mar87649/Autonomus-Rescue-Rover/Photos/20181127_203600.jpg

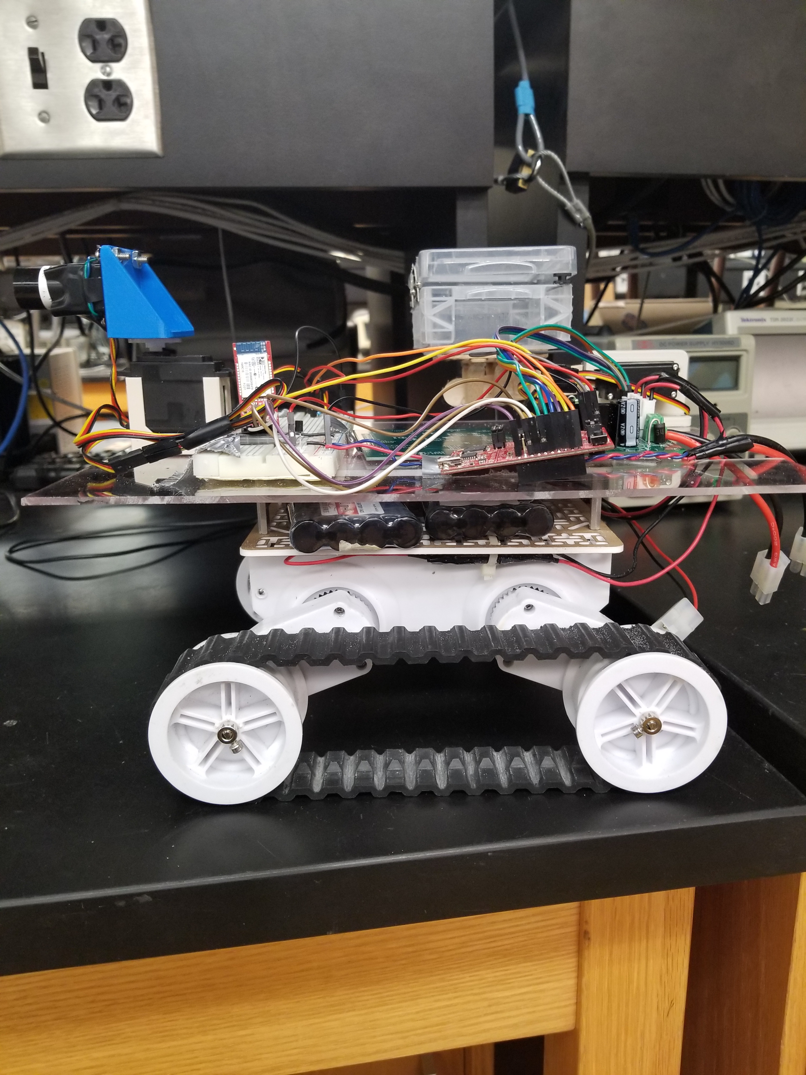
Photos/20181127_203600.jpg
