mar87649/Autonomus-Rescue-Rover/README.md

# Autonomous-Room-Mapping-Robot

# Description: 
Room mapping robot that can detect and avoid obstacles. 
Room is displayed in 2D via GUI.

# Status: 
Development has stopped
