mar87649/Autonomus-Rescue-Rover/PCB/board.PNG

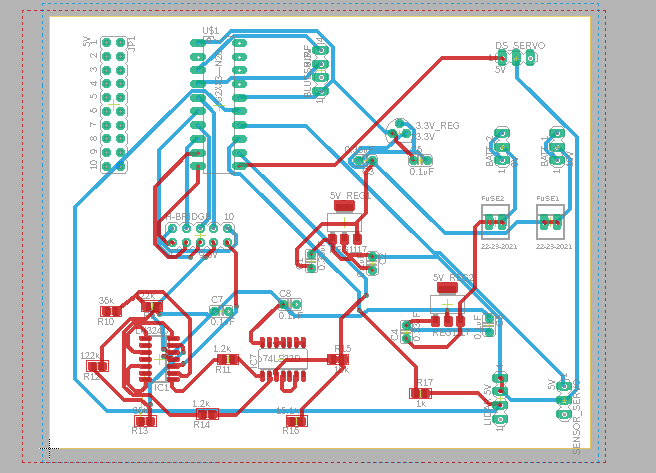
PCB/board.PNG
