mar87649/Autonomus-Rescue-Rover/Photos/20181113_170000.jpg

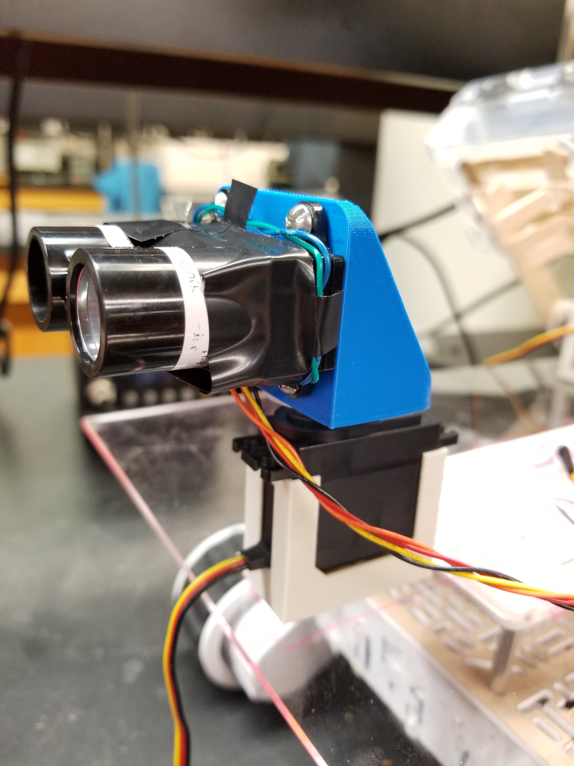
Photos/20181113_170000.jpg
