mar87649/Autonomus-Rescue-Rover/Photos/20181113_170115.jpg

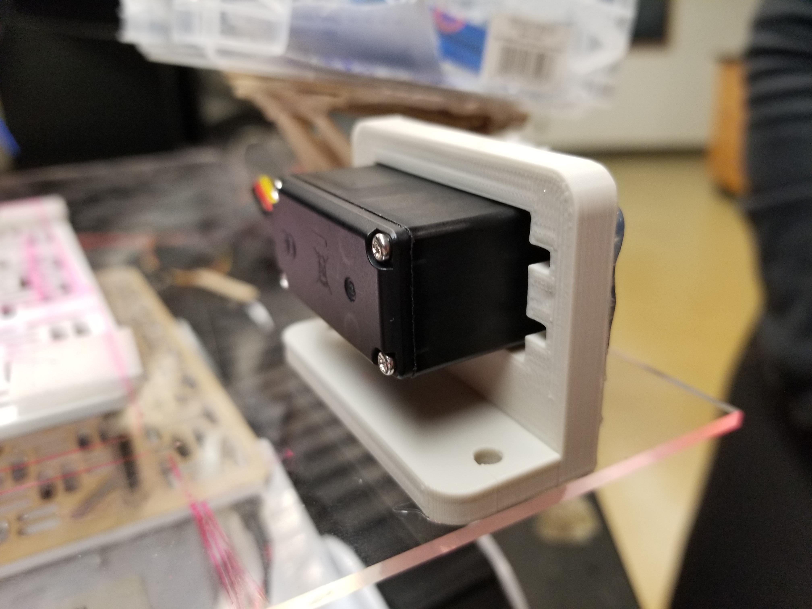
Photos/20181113_170115.jpg
