mar87649/Autonomus-Rescue-Rover/Photos/20181113_170211.jpg

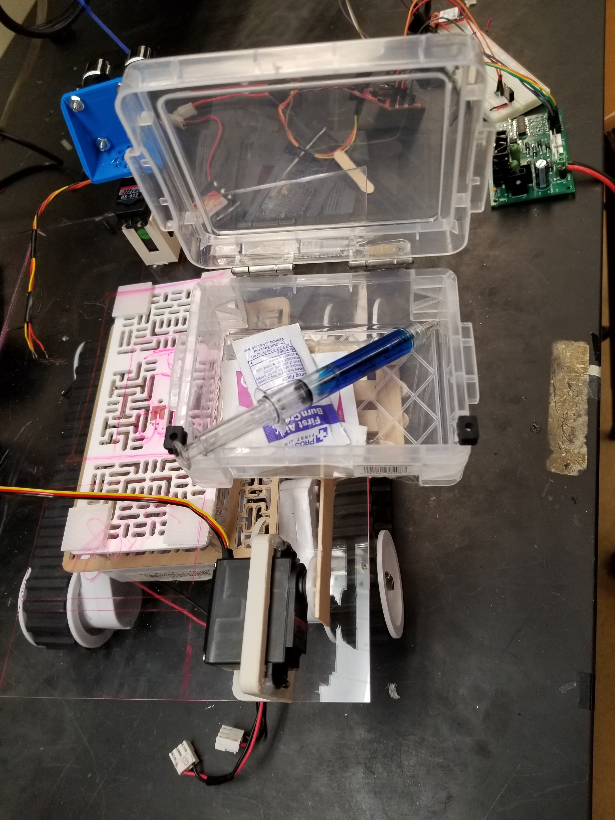
Photos/20181113_170211.jpg
