mar87649/Autonomus-Rescue-Rover/Photos/20181113_170213.jpg

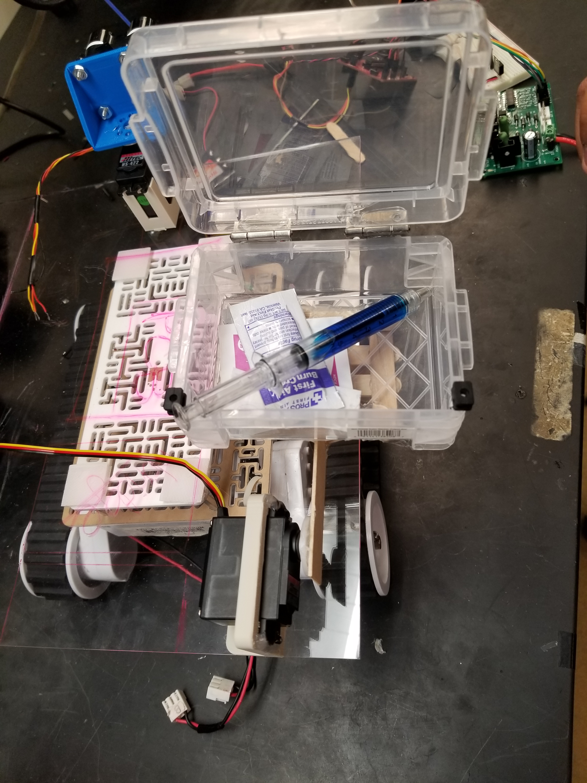
Photos/20181113_170213.jpg
