mar87649/Autonomus-Rescue-Rover/Photos/20181113_170230.jpg

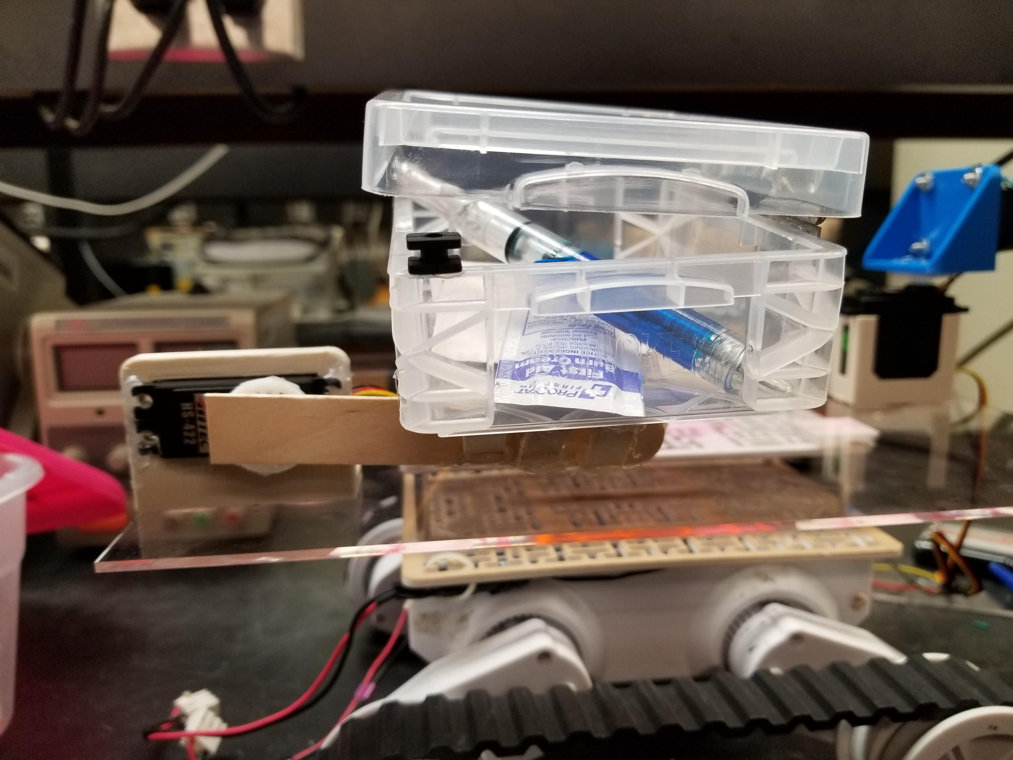
Photos/20181113_170230.jpg
