mar87649/Autonomus-Rescue-Rover/Photos/20181113_170255.jpg

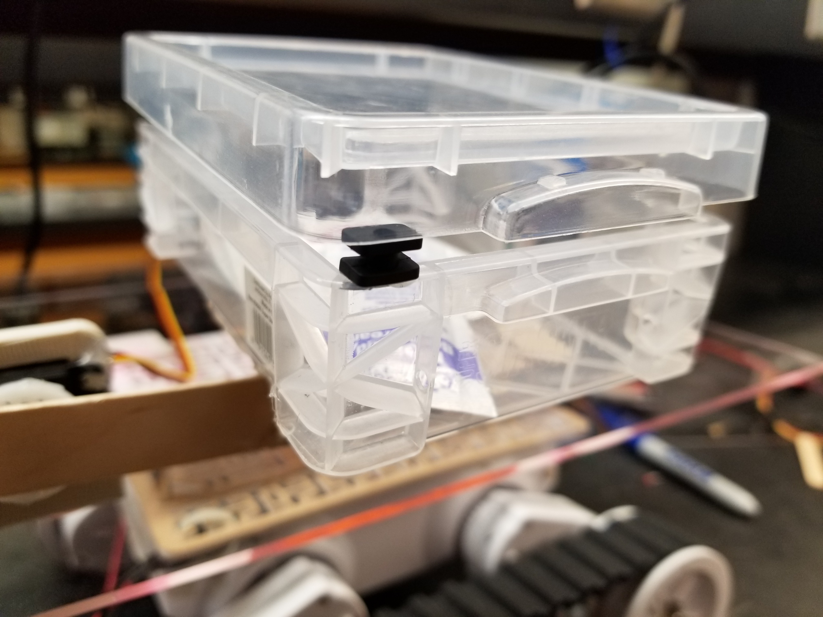
Photos/20181113_170255.jpg
