mar87649/Autonomus-Rescue-Rover/Photos/20181113_205037.jpg

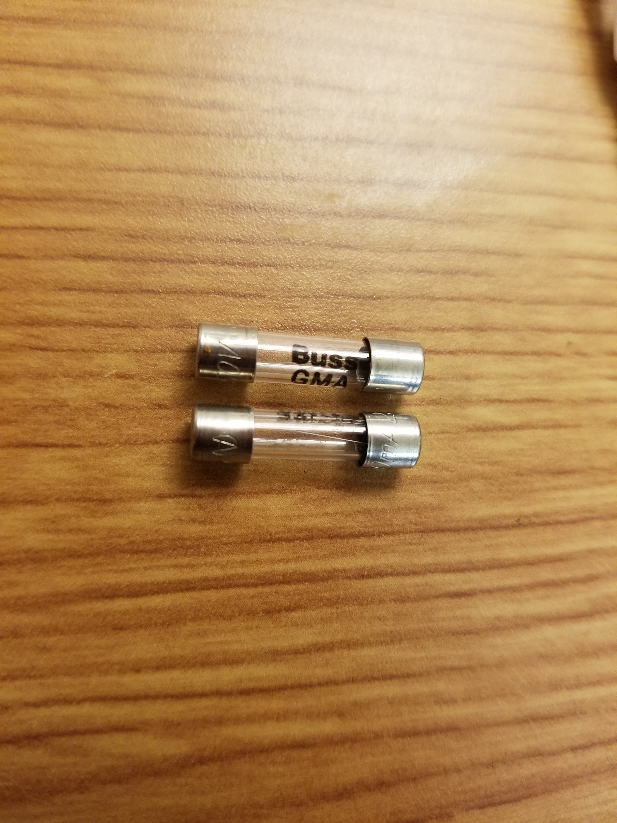
Photos/20181113_205037.jpg
