mar87649/Autonomus-Rescue-Rover/Photos/20181127_200213.jpg

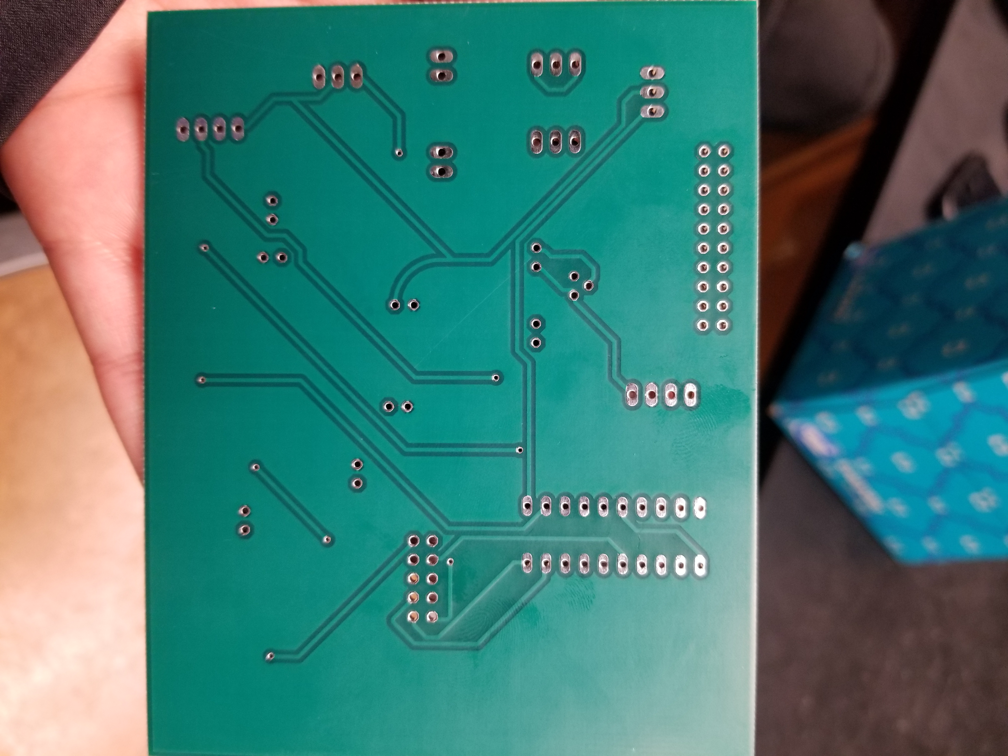
Photos/20181127_200213.jpg
