mar87649/Autonomus-Rescue-Rover/Photos/20181127_203509.jpg

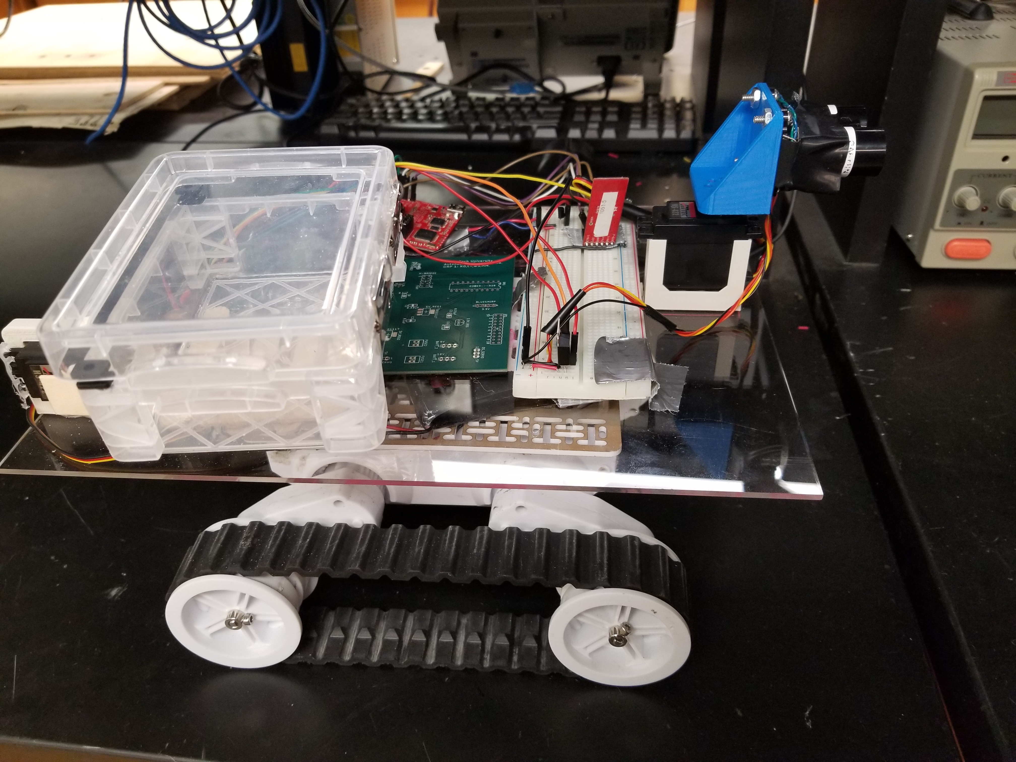
Photos/20181127_203509.jpg
