mar87649/Autonomus-Rescue-Rover/Photos/Snapchat-1557375275.jpg

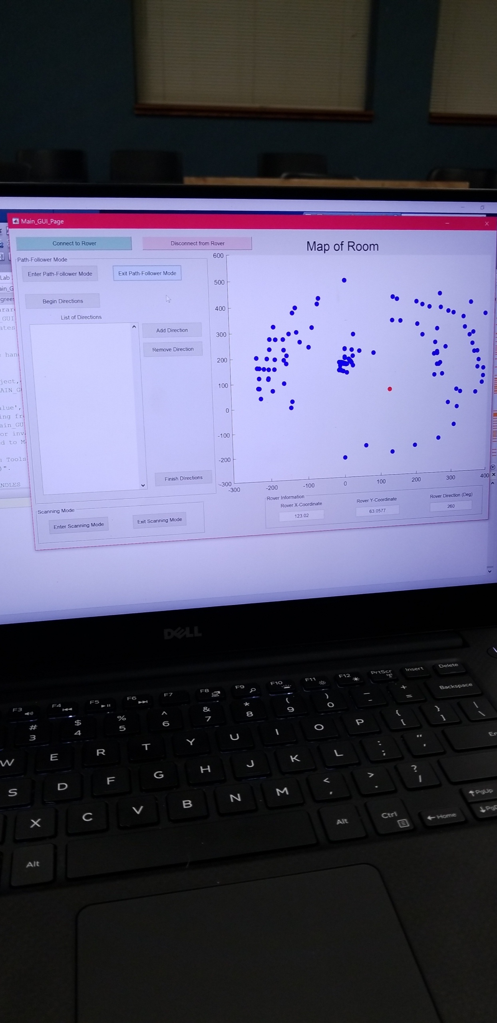
Photos/Snapchat-1557375275.jpg
