mar87649/Autonomus-Rescue-Rover/PCB/Lab 3 PCB_schematic_redo.brd

## EAGLE design PCB/Lab 3 PCB_schematic_redo.brd (2019-08-03)

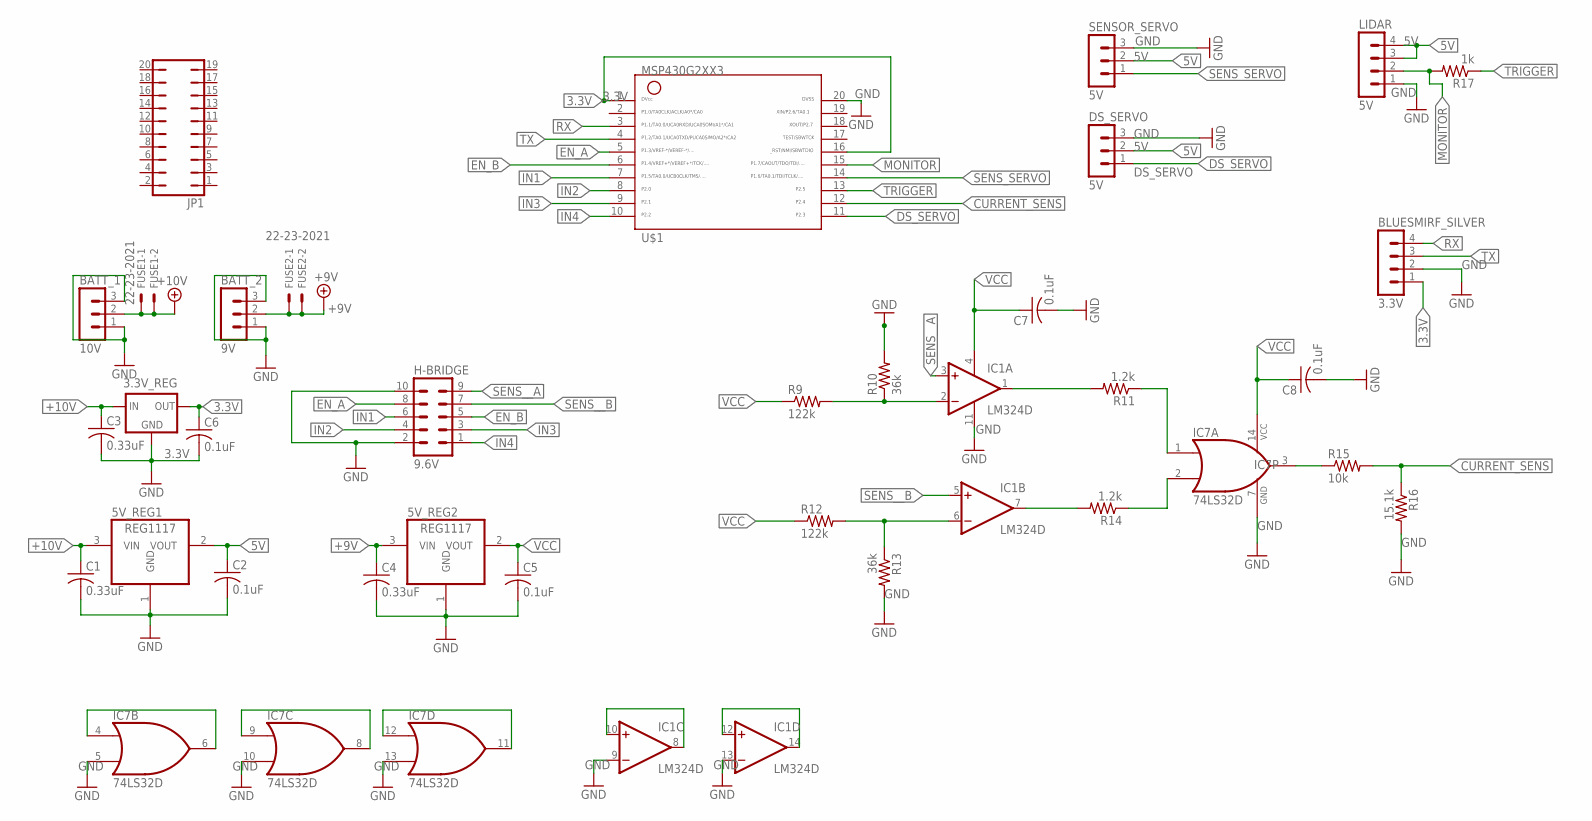
[picture p34: schematic Lab 3 PCB_schematic_redo.sch]

Parts:
3.3V_REG: 3.3V; 78LXX
5V_REG1, 5V_REG2: REG1117; SOT223
BATT_1: 10V; MA03-1
BATT_2: 9V; MA03-1
BLUESMIRF_SILVER: 3.3V; MA04-1
C1, C3, C4: 0.33uF; C025-024X044
C2, C5, C6, C7, C8: 0.1uF; C025-024X044
DS_SERVO: 5V; MA03-1
FUSE1, FUSE2: 22-23-2021
H-BRIDGE: 9.6V; MA05-2
IC1: LM324D; SO14
IC7: 74LS32D; SO14
JP1: JP10Q
LIDAR: 5V; MA04-1
R9, R12: 122k; R0805
R10, R13: 36k; R0805
R11, R14: 1.2k; R0805
R15: 10k; R0805
R16: 15.1k; R0805
R17: 1k; R0805
SENSOR_SERVO: 5V; MA03-1
U$1: G2XX3---N20; N20

Connections:
3.3V: 3.3V_REG.OUT, BLUESMIRF_SILVER.1, C6.1, U$1.1, U$1.16
5V: 5V_REG1.2 (VOUT), C2.1, DS_SERVO.2, LIDAR.3, LIDAR.4, SENSOR_SERVO.2
+9V: 5V_REG2.3 (VIN), BATT_2.2, C4.1, FUSE2.1, FUSE2.2
+10V: 3.3V_REG.IN, 5V_REG1.3 (VIN), BATT_1.2, C1.1, C3.1, FUSE1.1, FUSE1.2
CURRENT_SENS: R15.2, R16.1, U$1.12
DS_SERVO: DS_SERVO.1, U$1.11
EN_A: H-BRIDGE.8, U$1.5
EN_B: H-BRIDGE.5, U$1.6
GND: 3.3V_REG.GND, 5V_REG1.1 (GND), 5V_REG2.1 (GND), BATT_1.1, BATT_1.3, BATT_2.1, BATT_2.3, BLUESMIRF_SILVER.2, C1.2, C2.2, C3.2, C4.2, C5.2, C6.2, C7.2, C8.2, DS_SERVO.3, H-BRIDGE.2, H-BRIDGE.10, IC1.9 (-IN), IC1.11 (V-), IC1.13 (-IN), IC7.5 (I1), IC7.7 (GND), IC7.10 (I1), IC7.13 (I1), LIDAR.1, R10.2, R13.2, R16.2, SENSOR_SERVO.3, U$1.20
IN1: H-BRIDGE.6, U$1.7
IN2: H-BRIDGE.4, U$1.8
IN3: H-BRIDGE.3, U$1.9
IN4: H-BRIDGE.1, U$1.10
MONITOR: LIDAR.2, R17.2, U$1.15
unnamed: IC7.4 (I0), IC7.6 (O)
unnamed: IC1.6 (-IN), R12.2, R13.1
unnamed: IC1.2 (-IN), R9.2, R10.1
unnamed: IC7.1 (I0), R11.1
unnamed: IC1.8 (OUT), IC1.10 (+IN)
unnamed: IC1.1 (OUT), R11.2
unnamed: IC1.7 (OUT), R14.2
unnamed: IC7.2 (I1), R14.1
unnamed: IC7.3 (O), R15.1
unnamed: IC7.8 (O), IC7.9 (I0)
unnamed: IC7.11 (O), IC7.12 (I0)
unnamed: IC1.12 (+IN), IC1.14 (OUT)
RX: BLUESMIRF_SILVER.4, U$1.3
SENS_SERVO: SENSOR_SERVO.1, U$1.14
SENS__A: H-BRIDGE.9, IC1.3 (+IN)
SENS__B: H-BRIDGE.7, IC1.5 (+IN)
TRIGGER: R17.1, U$1.13
TX: BLUESMIRF_SILVER.3, U$1.4
VCC: 5V_REG2.2 (VOUT), C5.1, C7.1, C8.1, IC1.4 (V+), IC7.14 (VCC), R9.1, R12.1

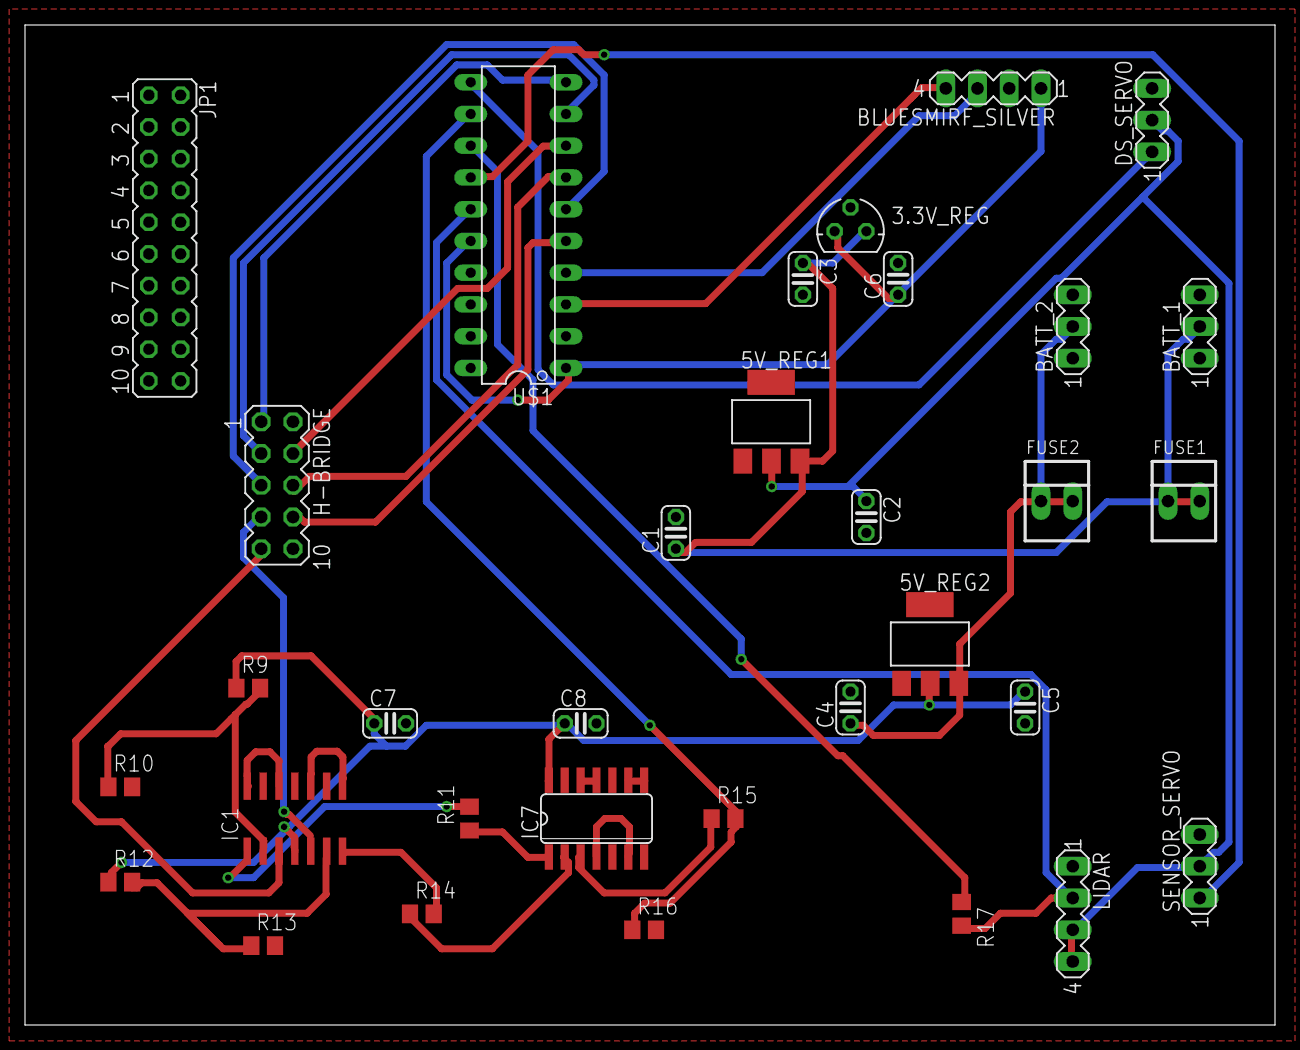
[picture p35: board Lab 3 PCB_schematic_redo.brd from above]

Board: 2 copper layers, 100.0 x 80.0 mm, 33 parts (0 on the bottom side), 33 nets.
