mar87649/Autonomus-Rescue-Rover/Library Motor Control/Include/MotorControl.h

/*
 * MotorControl.h
 *
 *  Created on: Sep 30, 2018
 *      Author: Gaming-Jim
 */

#ifndef DEBUG_INCLUDE_MOTORCONTROL_H_
#define DEBUG_INCLUDE_MOTORCONTROL_H_

int add(int a, int b);

void motor_A_clockwise();

void motor_A_counterclockwise();

void motor_B_clockwise();

void motor_B_counterclockwise();

void move_forward();

void move_reverse();

void turn_left();

void turn_right();

void stop();

#endif /* DEBUG_INCLUDE_MOTORCONTROL_H_ */
