mar87649/Autonomus-Rescue-Rover/graph.py

# -*- coding: utf-8 -*-

# Form implementation generated from reading ui file 'graph.ui'
#
# Created by: PyQt5 UI code generator 5.11.3
#
# WARNING! All changes made in this file will be lost!

from PyQt5 import QtCore, QtGui, QtWidgets

class Ui_MainWindow(object):
    def setupUi(self, MainWindow):
        MainWindow.setObjectName("MainWindow")
        self.centralwidget = QtWidgets.QWidget(MainWindow)
        self.centralwidget.setObjectName("centralwidget")
        self.pushButton = QtWidgets.QPushButton(self.centralwidget)
        self.pushButton.setGeometry(QtCore.QRect(310, 140, 75, 23))
        self.pushButton.setObjectName("pushButton")
        self.pushButton_2 = QtWidgets.QPushButton(self.centralwidget)
        self.pushButton_2.setGeometry(QtCore.QRect(310, 200, 75, 23))
        self.pushButton_2.setObjectName("pushButton_2")
        self.pushButton_3 = QtWidgets.QPushButton(self.centralwidget)
        self.pushButton_3.setGeometry(QtCore.QRect(230, 170, 75, 23))
        self.pushButton_3.setObjectName("pushButton_3")
        self.pushButton_4 = QtWidgets.QPushButton(self.centralwidget)
        self.pushButton_4.setGeometry(QtCore.QRect(390, 170, 75, 23))
        self.pushButton_4.setObjectName("pushButton_4")
        self.pushButton_5 = QtWidgets.QPushButton(self.centralwidget)
        self.pushButton_5.setGeometry(QtCore.QRect(310, 170, 75, 23))
        self.pushButton_5.setObjectName("pushButton_5")
        self.pushButton_6 = QtWidgets.QPushButton(self.centralwidget)
        self.pushButton_6.setGeometry(QtCore.QRect(10, 140, 75, 23))
        self.pushButton_6.setObjectName("pushButton_6")
        self.pushButton_7 = QtWidgets.QPushButton(self.centralwidget)
        self.pushButton_7.setGeometry(QtCore.QRect(10, 170, 75, 23))
        self.pushButton_7.setObjectName("pushButton_7")
        self.pushButton_8 = QtWidgets.QPushButton(self.centralwidget)
        self.pushButton_8.setGeometry(QtCore.QRect(10, 200, 75, 23))
        self.pushButton_8.setObjectName("pushButton_8")
        self.pushButton_9 = QtWidgets.QPushButton(self.centralwidget)
        self.pushButton_9.setGeometry(QtCore.QRect(100, 200, 75, 23))
        self.pushButton_9.setObjectName("pushButton_9")
        self.pushButton_10 = QtWidgets.QPushButton(self.centralwidget)
        self.pushButton_10.setGeometry(QtCore.QRect(100, 170, 75, 23))
        self.pushButton_10.setObjectName("pushButton_10")
        self.pushButton_11 = QtWidgets.QPushButton(self.centralwidget)
        self.pushButton_11.setGeometry(QtCore.QRect(100, 140, 75, 23))
        self.pushButton_11.setObjectName("pushButton_11")
        MainWindow.setCentralWidget(self.centralwidget)
        self.menubar = QtWidgets.QMenuBar(MainWindow)
        self.menubar.setGeometry(QtCore.QRect(0, 0, 500, 21))
        self.menubar.setObjectName("menubar")
        MainWindow.setMenuBar(self.menubar)
        self.statusbar = QtWidgets.QStatusBar(MainWindow)
        self.statusbar.setObjectName("statusbar")
        MainWindow.setStatusBar(self.statusbar)

        self.retranslateUi(MainWindow)
        QtCore.QMetaObject.connectSlotsByName(MainWindow)

    def retranslateUi(self, MainWindow):
        _translate = QtCore.QCoreApplication.translate
        MainWindow.setWindowTitle(_translate("MainWindow", "MainWindow"))
        self.pushButton.setText(_translate("MainWindow", "PushButton"))
        self.pushButton_2.setText(_translate("MainWindow", "PushButton"))
        self.pushButton_3.setText(_translate("MainWindow", "PushButton"))
        self.pushButton_4.setText(_translate("MainWindow", "PushButton"))
        self.pushButton_5.setText(_translate("MainWindow", "PushButton"))
        self.pushButton_6.setText(_translate("MainWindow", "PushButton"))
        self.pushButton_7.setText(_translate("MainWindow", "PushButton"))
        self.pushButton_8.setText(_translate("MainWindow", "PushButton"))
        self.pushButton_9.setText(_translate("MainWindow", "PushButton"))
        self.pushButton_10.setText(_translate("MainWindow", "PushButton"))
        self.pushButton_11.setText(_translate("MainWindow", "PushButton"))
