mar87649/Autonomus-Rescue-Rover/Photos/20181127_203526.jpg

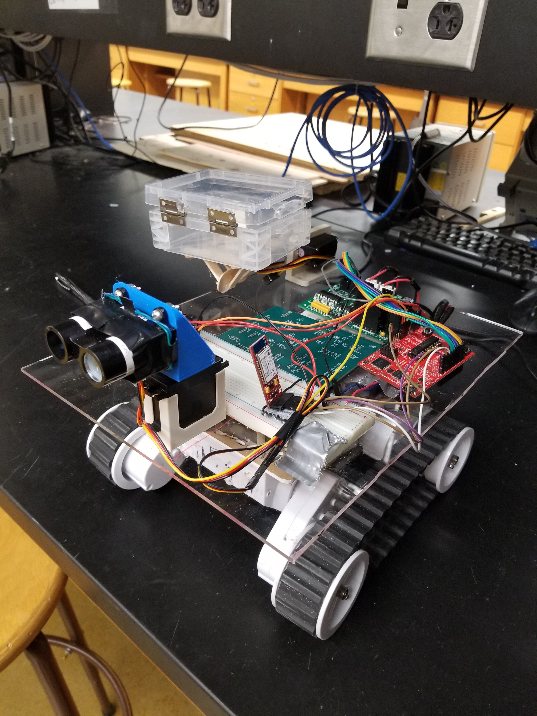
Photos/20181127_203526.jpg
