mar87649/Autonomus-Rescue-Rover/Photos/20181017_150634.jpg

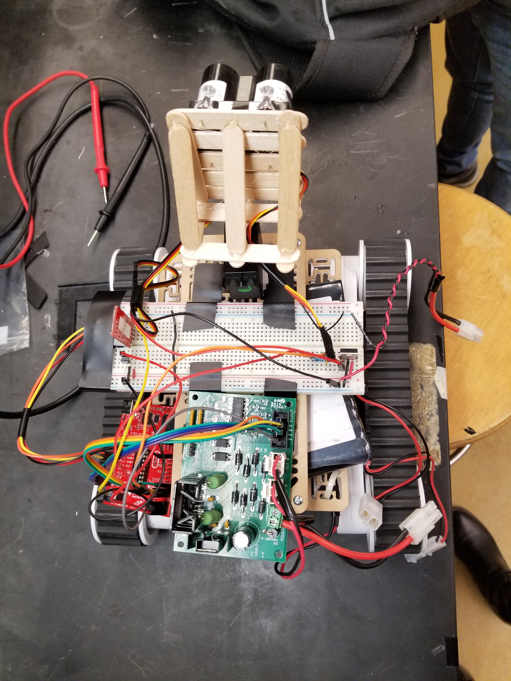
Photos/20181017_150634.jpg
